tinycore-hisanori/kachi-sense/docs/schematic.png

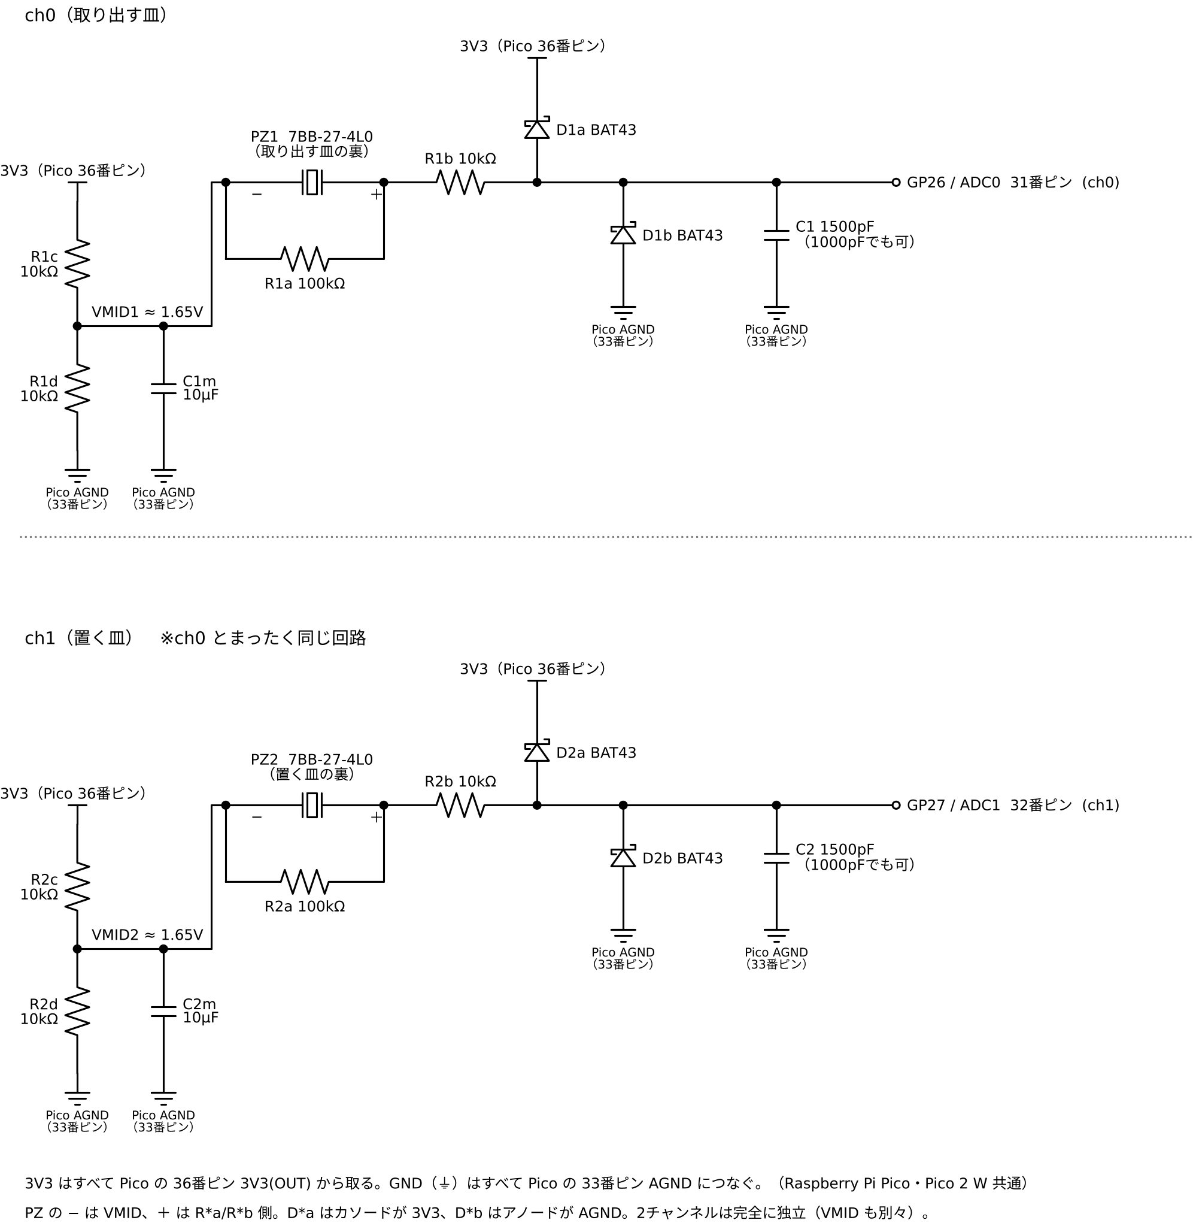
docs/schematic.png
