tinycore-hisanori/kachi-sense/docs/schematic_amp.png

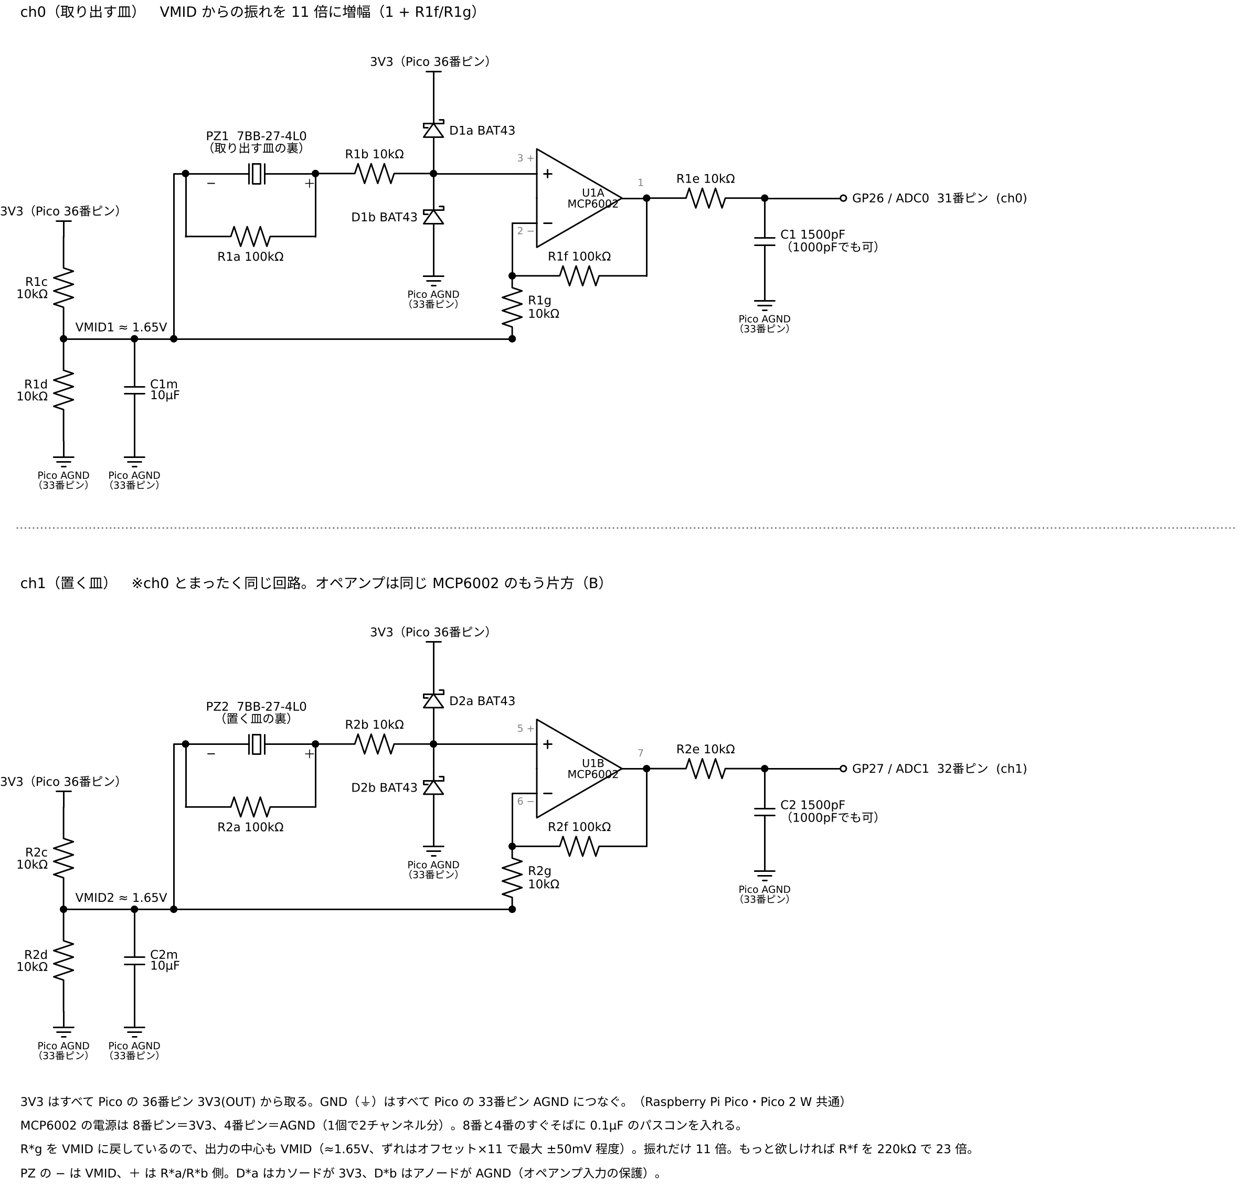
docs/schematic_amp.png
