tinycore-hisanori/kachi-sense/docs/bom.md

# 部品表（秋月電子通商）

v2 回路（[schematic_amp.png](schematic_amp.png)：MCP6002 で 11 倍に増幅）の 2 チャンネル（取り出す皿・置く皿）分です。2 チャンネルはまったく同じ回路で、VMID も別々に作ります。販売コードと価格は 2026 年 11 月 10 日に秋月電子の商品ページで確認したものです。在庫と価格は変わるので、注文前に確認してください。

| # | 部品 | 秋月 販売コード | 使う数 | 買う単位 | 参考価格（税込） | 回路図の記号・メモ |
|---|---|---|---|---|---|---|
| 1 | Raspberry Pi Pico 2 W（または Pico / Pico W / Pico 2） | — | 1 | 1個 | — | どれでも同じ配線で動く。ファームはボードに合わせて書き込む（README 参照） |
| 2 | 2回路入 レールtoレール CMOS オペアンプ MCP6002-E/P（DIP 8ピン） | [130011](https://akizukidenshi.com/catalog/g/g130011/) | 1 | 1個 | ¥80 | U1。A 側（1〜3番ピン）が ch0、B 側（5〜7番ピン）が ch1。8番＝3V3、4番＝AGND |
| 3 | 圧電サウンダー 7BB-27-4L0（村田、27mm、リード線付き） | [113209](https://akizukidenshi.com/catalog/g/g113209/) | 2 | 1個 | ¥80 × 2 | PZ1・PZ2。共振 4.6 kHz で、豆の着地音（2〜6 kHz）と重なる |
| 4 | ショットキーバリアダイオード BAT43（DO-35） | [113907](https://akizukidenshi.com/catalog/g/g113907/) | 4 | 10本入 | ¥150 | D1a・D1b・D2a・D2b。オペアンプ入力の保護 |
| 5 | カーボン抵抗 1/4W 10kΩ | [125103](https://akizukidenshi.com/catalog/g/g125103/) | 10 | 100本入 | ¥100 | 1チャンネルに5本：R*c・R*d（VMID の分圧）、R*b（入力）、R*g（ゲイン）、R*e（ADC 前のローパス） |
| 6 | カーボン抵抗 1/4W 100kΩ | [125104](https://akizukidenshi.com/catalog/g/g125104/) | 4 | 100本入 | ¥200 | 1チャンネルに2本：R*a（圧電素子のバイアス）、R*f（帰還）。R*f を 220kΩ にすると 23 倍 |
| 7 | 積層セラミックコンデンサー 1500pF 50V X7R 5mm | [108133](https://akizukidenshi.com/catalog/g/g108133/) | 2 | 10個入 | ¥100 | C1・C2。ADC 前のローパス（約 10 kHz）。1000pF でも可（約 16 kHz） |
| 8 | 積層セラミックコンデンサー 10μF 50V X7S 5mm | [108155](https://akizukidenshi.com/catalog/g/g108155/) | 2 | 1個 | ¥60 × 2 | C1m・C2m。VMID の安定化（1チャンネルに1個） |
| 9 | 積層セラミックコンデンサー 0.1μF 50V X7R 2.54mm | [113582](https://akizukidenshi.com/catalog/g/g113582/) | 1 | 10個入 | ¥100 | MCP6002 のパスコン。8番ピンと4番ピンのすぐそばに |

**合計の目安**：Pico 本体を除いて約 1,000 円

### v1（増幅なし）から足すもの

v1 の部品をすでに持っている場合、買い足すのは **MCP6002（#2）、10μF をもう1個（#8）、0.1μF（#9）** だけです。抵抗は 100 本入りなので足ります。

## 秋月以外で用意するもの

- ブレッドボードとジャンパーワイヤー（手持ちのもので可）
- 小皿 2 枚：薄手の磁器（白くて硬い小皿）がおすすめ。厚手の陶器は高い音を吸うので避ける。ステンレスも使えるが、圧電素子の真鍮面（− 側）と皿が導通するので、カプトンテープなどで絶縁を1枚挟む
- 炒り豆（大豆）
- 瞬間接着剤かエポキシ：圧電素子を皿の裏に貼るため。両面テープはクッションで高い音を吸うので、感度が落ちる
- ピンセット：デモでハンドの代わりに豆を落とす

## 部品を選んだ理由

- **7BB-27-4L0**：リード線付きなので、はんだ付けしにくい電極を直接扱わずに済みます。静電容量は 20 nF（1 kHz、村田の仕様値）で、100 kΩ のバイアス抵抗と組み合わせた低域の切れ目は約 80 Hz です。豆の音（2〜6 kHz）より十分低いので、信号を削りません。共振が 4.6 kHz で豆の音の帯域と重なるのも、この部品を選んだ理由です。
- **MCP6002**：3.3 V 単電源で、入力も出力もレール近くまで振れます。入力バイアス電流が 1 pA と小さいので、100 kΩ で浮かせた圧電素子をそのまま受けられます。帯域は 1 MHz ÷ 11 ≈ 90 kHz で、豆の音には十分です。2 回路入りなので 1 個で 2 チャンネル分をまかなえます。
- **BAT43**：秋月で在庫のある、リード付きの小信号ショットキーです。皿を強く叩いたときに圧電素子が出す大きな電圧から、オペアンプの入力を守ります。漏れ電流は 0.5 μA なので、100 kΩ のバイアスを通っても中点電圧のずれは 50 mV 程度に収まります（[docs/wiring.md](wiring.md) 参照）。
