tinycore-hisanori/kachi-sense/(commit log)

2026-11-02 kachi-sense: piezo click detector for robot-hand pick-and-place labeling
    RP2040 firmware and Python reference detector that tell a bean landing
    (2-6 kHz click) from a finger knocking the plate (low-frequency thud),
    plus a serial logger and a trial labeler (success / dropped / double / miss).
    Tested on synthetic plate signals; C++ and Python versions are checked to match.
    Claude-Session: https://claude.ai/code/session_01TesNTqEianzqQXUFRLWi89
2026-11-02 Add Akizuki parts list; switch clamp to BAT43 and bias to 100k
    Akizuki's BAT54S variant is out of stock and SOT-523, so the clamp is now
    two through-hole BAT43 per channel. The bias resistor drops from 1M to
    100k so the diode leakage (0.5 uA) moves the mid-rail by ~50 mV at most;
    with the 0.2 uF 7BB-27 piezo the low corner stays near 8 Hz.
    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
2026-11-02 Add rendered schematic (SVG/PNG) and its generator
    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
2026-11-02 README: explain why sound beats a camera and how the IIR filter separates clicks
    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
2026-11-02 README: document the filter design (2nd-order Butterworth IIR) and why IIR over FIR
    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
2026-11-02 BOM: add 1500pF capacitor price (10 pcs, 100 yen)
    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
2026-11-02 Add Web Serial live demo page and T/Q serial commands
    docs/demo/index.html connects to the Pico over Web Serial and shows
    success (target-plate click), drop (source-plate click) and ignored
    knocks (thud) with big counters and flashing plates, for recording the
    demo video. It sends 'T' on connect so the firmware reports thuds; the
    firmware now accepts 'T' (thuds on) and 'Q' (off) besides the 't' toggle.
    A demo mode runs on simulated events when no board is attached.
    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
2026-11-04 Add GitHub Actions CI: pytest + Pico firmware build (UF2 artifact)
    Claude-Session: https://claude.ai/code/session_01TesNTsNsH5ERwRpkjccMkz
2026-11-04 CI: also build firmware for Raspberry Pi Pico 2 W (RP2350)
    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
2026-11-04 Schematic: draw both channels (ch0 GP26, ch1 GP27) with shared VMID
    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
2026-11-04 Schematic/docs: two fully independent channels (each with its own VMID)
    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
2026-11-04 Schematic: label every 3V3 / GND symbol with its Pico pin (36 / 33 AGND)
    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
2026-11-04 Firmware: support Pico 2 W explicitly, version line, volatile tail; README: Arduino IDE steps
    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
2026-11-04 Firmware 0.1.2: LED blink off by default on W boards (LED writes cause false clicks), L toggles; status shows dc/floor
    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
2026-11-10 Docs: fix 7BB-27-4L0 capacitance (20 nF, not 0.2 uF) and the resulting 80 Hz corner
    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
2026-11-10 Add v2 schematic with MCP6002 x11 preamp (docs/schematic_amp.png)
    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
2026-11-10 BOM for v2 (MCP6002 preamp) with Akizuki codes; README points to v2 schematic
    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
2026-11-10 wiring.md: point to v2 amp schematic
    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
